gsarenas/REC-3DP/FIRMWARE/README.md

## REC_3DP_V2  
Firmware funcional com a programação necessária para o projeto

## REC_3DP_V3
Firmware funcional completo com interface visual com comunicação UART (serial USB)  
Funções básicas implementadas:
* F___: Feed Rate (controle da velocidade do motor)
* M104 S___: Set Hotend Temperature (controle da temperatura do hotend)

## Bibliotecas  
Para o funcionamento deste projeto, foram utilizadas as bibliotecas:  
* LiquidCrystal_I2C: [LiquidCrystal-master](Bibliotecas/LiquidCrystal_I2C-master.zip)  
* MightyCore: [MightyCore-master](Bibliotecas/MightyCore-master.zip)
