gsarenas/REC-3DP/FIRMWARE/REC_3DP_V3/usr/IMG/CTC-Mode-Diagram-Pequeno.png

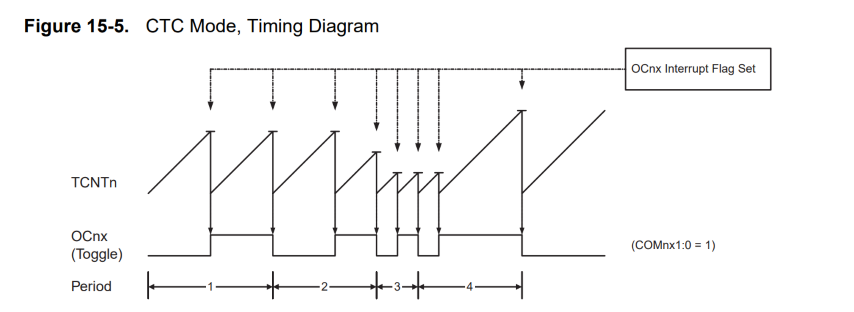
FIRMWARE/REC_3DP_V3/usr/IMG/CTC-Mode-Diagram-Pequeno.png
