gsarenas/REC-3DP/HARDWARE/ELÉTRICA/REF/Ender_3_Mainbord_PCB.png

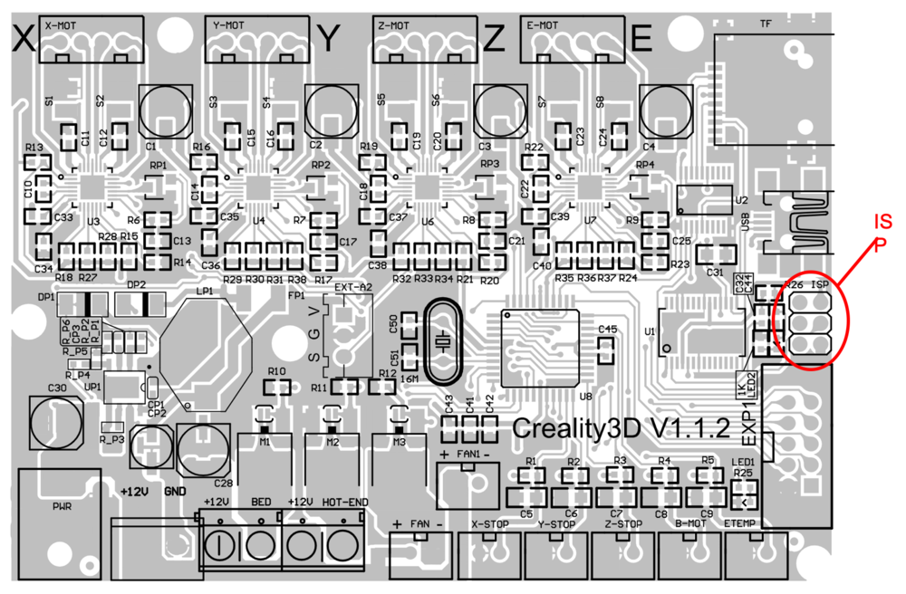
HARDWARE/ELÉTRICA/REF/Ender_3_Mainbord_PCB.png
