gsarenas/REC-3DP/HARDWARE/ELÉTRICA/REF/lcd_display_dimensions.png

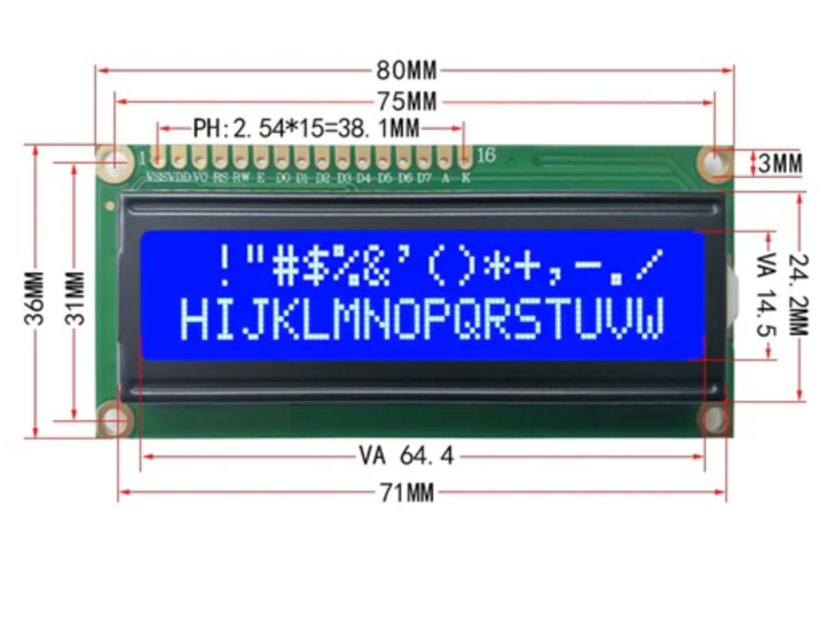
HARDWARE/ELÉTRICA/REF/lcd_display_dimensions.png
