gsarenas/REC-3DP/HARDWARE/ELÉTRICA/REF/Generic_3D_Printer_Controller_Board_PCB_Layout.jpg

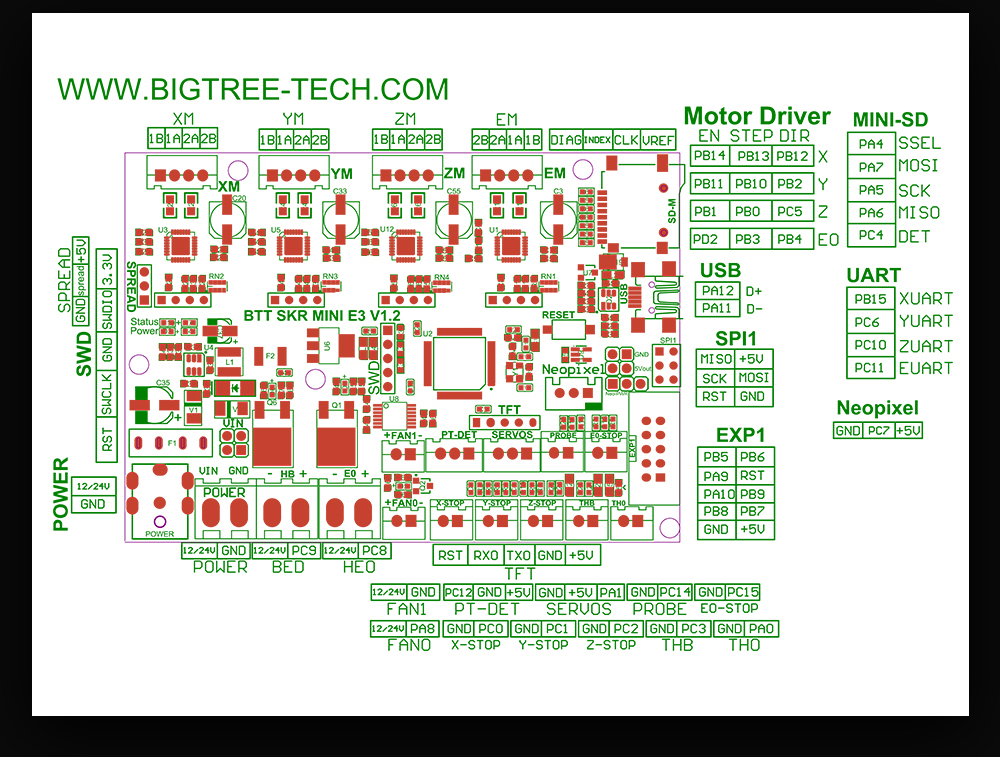
HARDWARE/ELÉTRICA/REF/Generic_3D_Printer_Controller_Board_PCB_Layout.jpg
