gsarenas/REC-3DP/FIRMWARE/REC_3DP_V3/usr/IMG/Testes_SP-150_Kp-35_Limpo.png

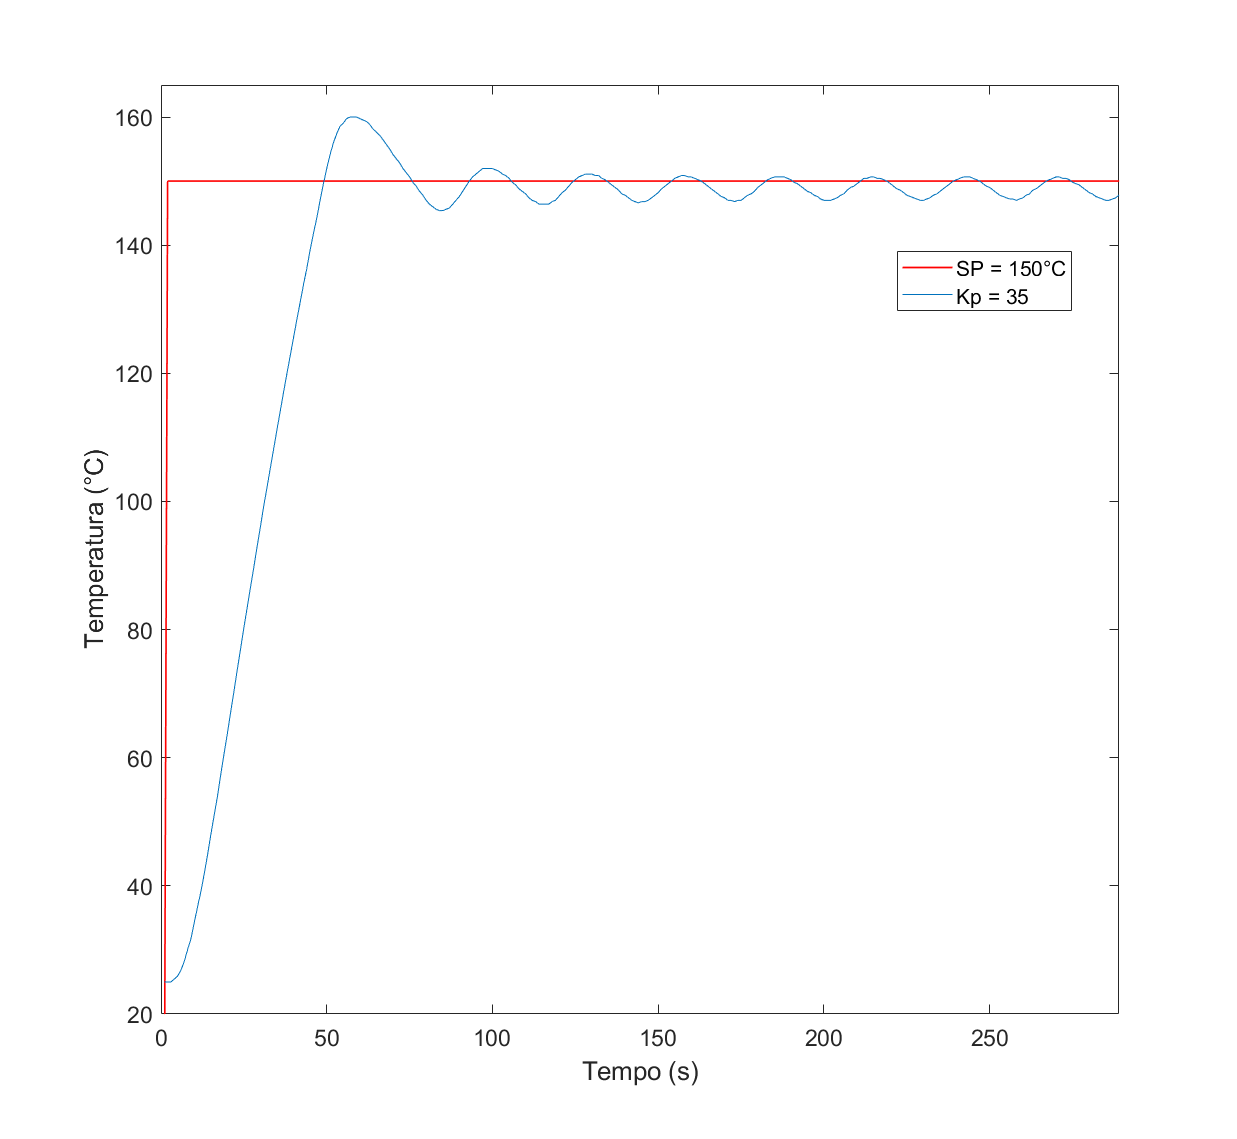
FIRMWARE/REC_3DP_V3/usr/IMG/Testes_SP-150_Kp-35_Limpo.png
