gsarenas/REC-3DP/HARDWARE/ELÉTRICA/REF/Ender_3_Schematic.PDF

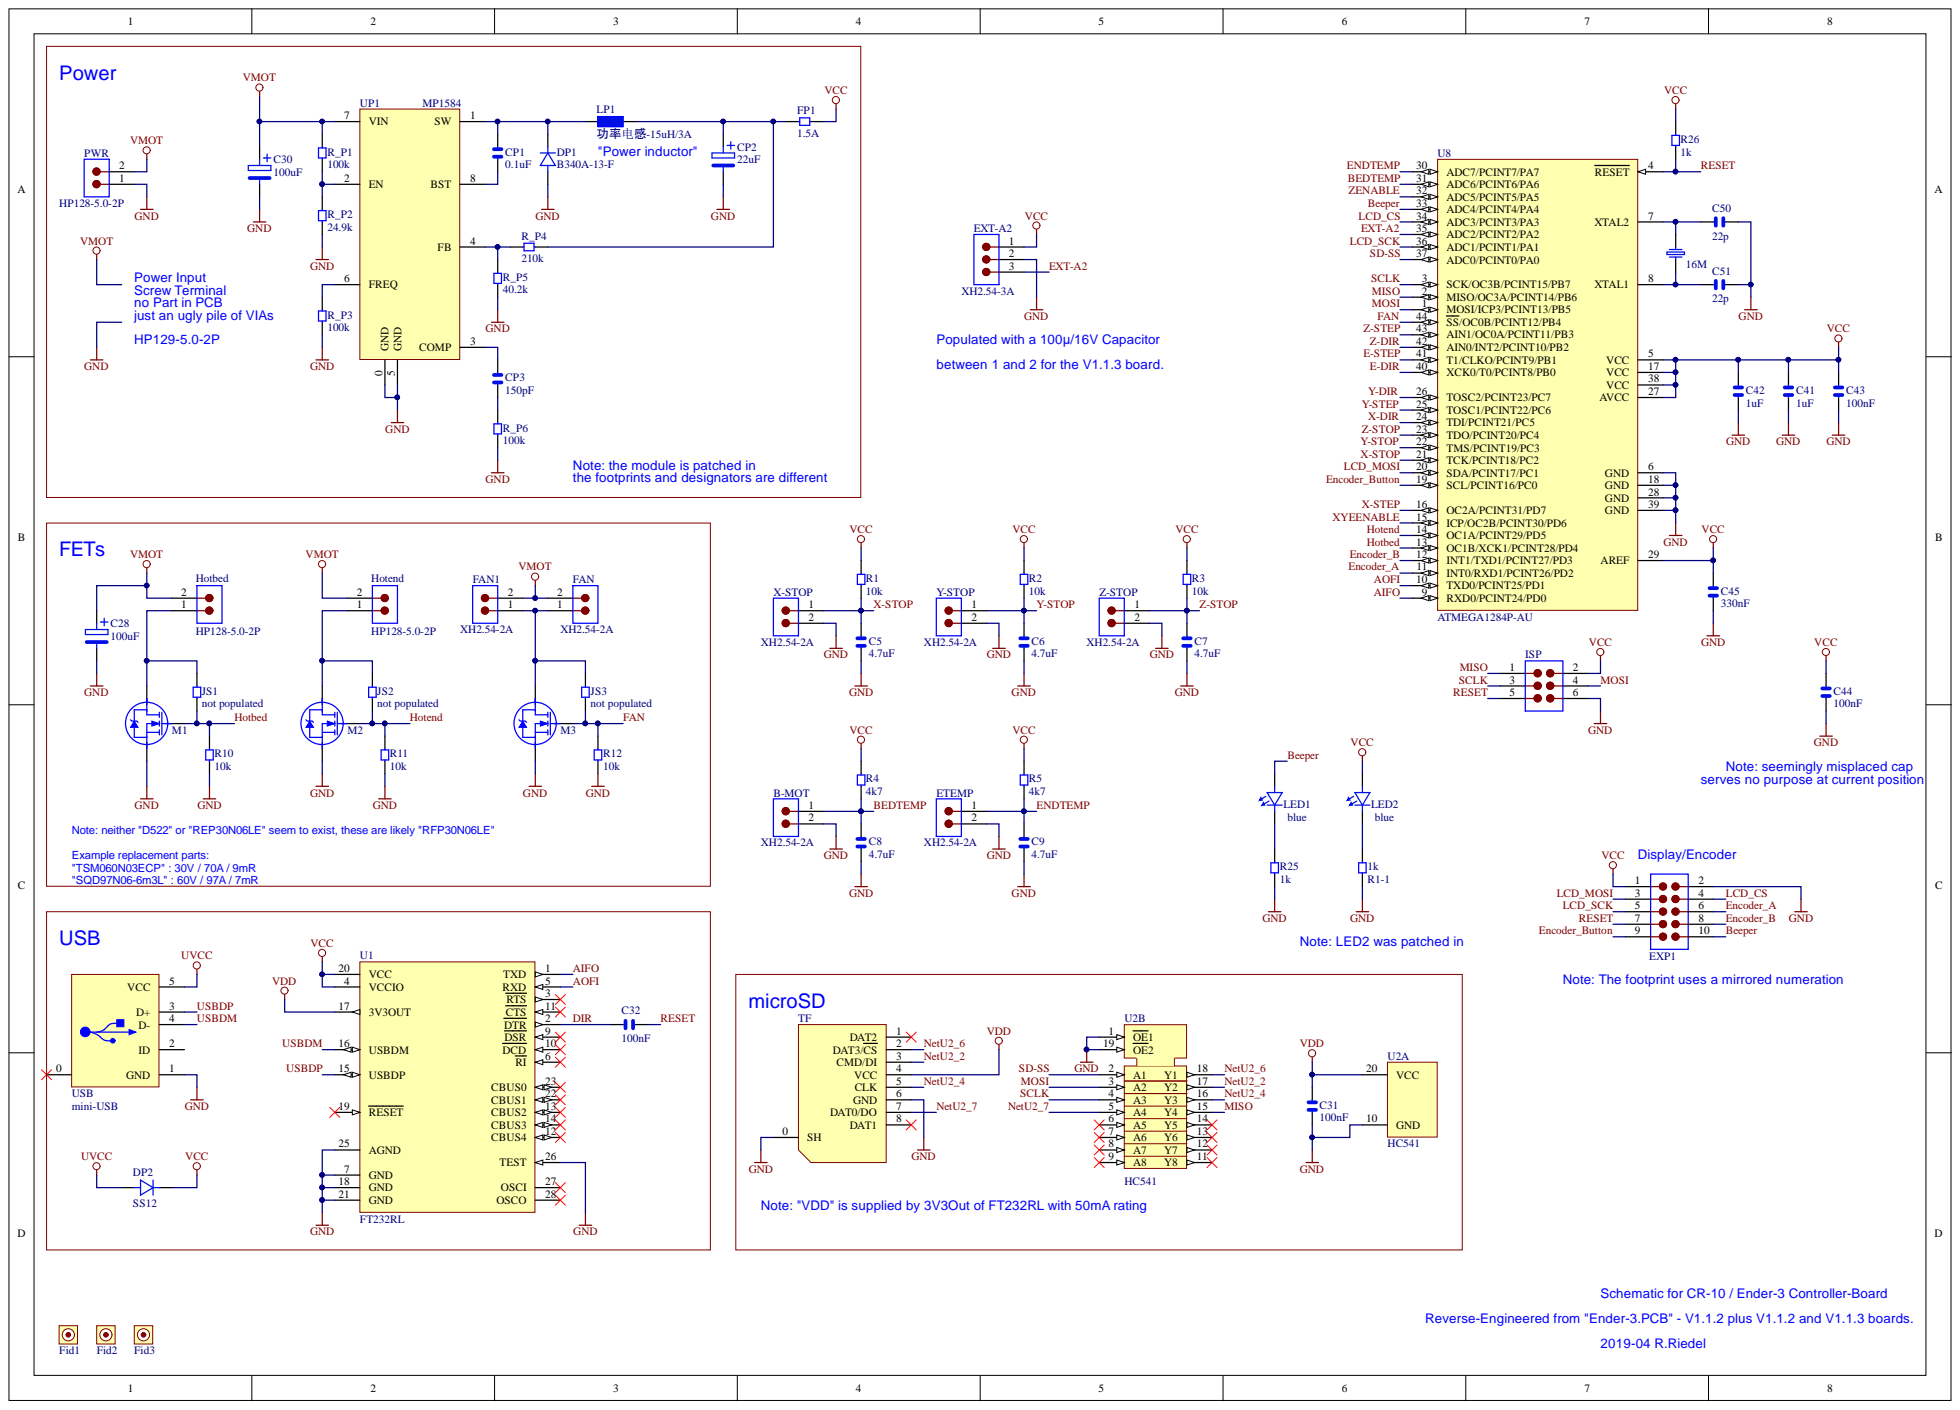
[picture p22: page 1]

Power Input
Screw Terminal no Part in PCB

just an ugly pile of VIAs

between 1 and 2 for the V1.1.3 board.

Note: the module is patched in
the footprints and designators are different

serves no purpose at current position Note: seemingly misplaced cap

Note: neither "D522" or "REP30N06LE" seem to exist, these are likely "RFP30N06LE"

GND
Note: LED2 was patched in

Note: The footprint uses a mirrored numeration

GND 7

GND 21

Note: "VDD" is supplied by 3V3Out of FT232RL with 50mA rating

Schematic for CR-10 / Ender-3 Controller-Board

Reverse-Engineered from "Ender-3.PCB" - V1.1.2 plus V1.1.2 and V1.1.3 boards.

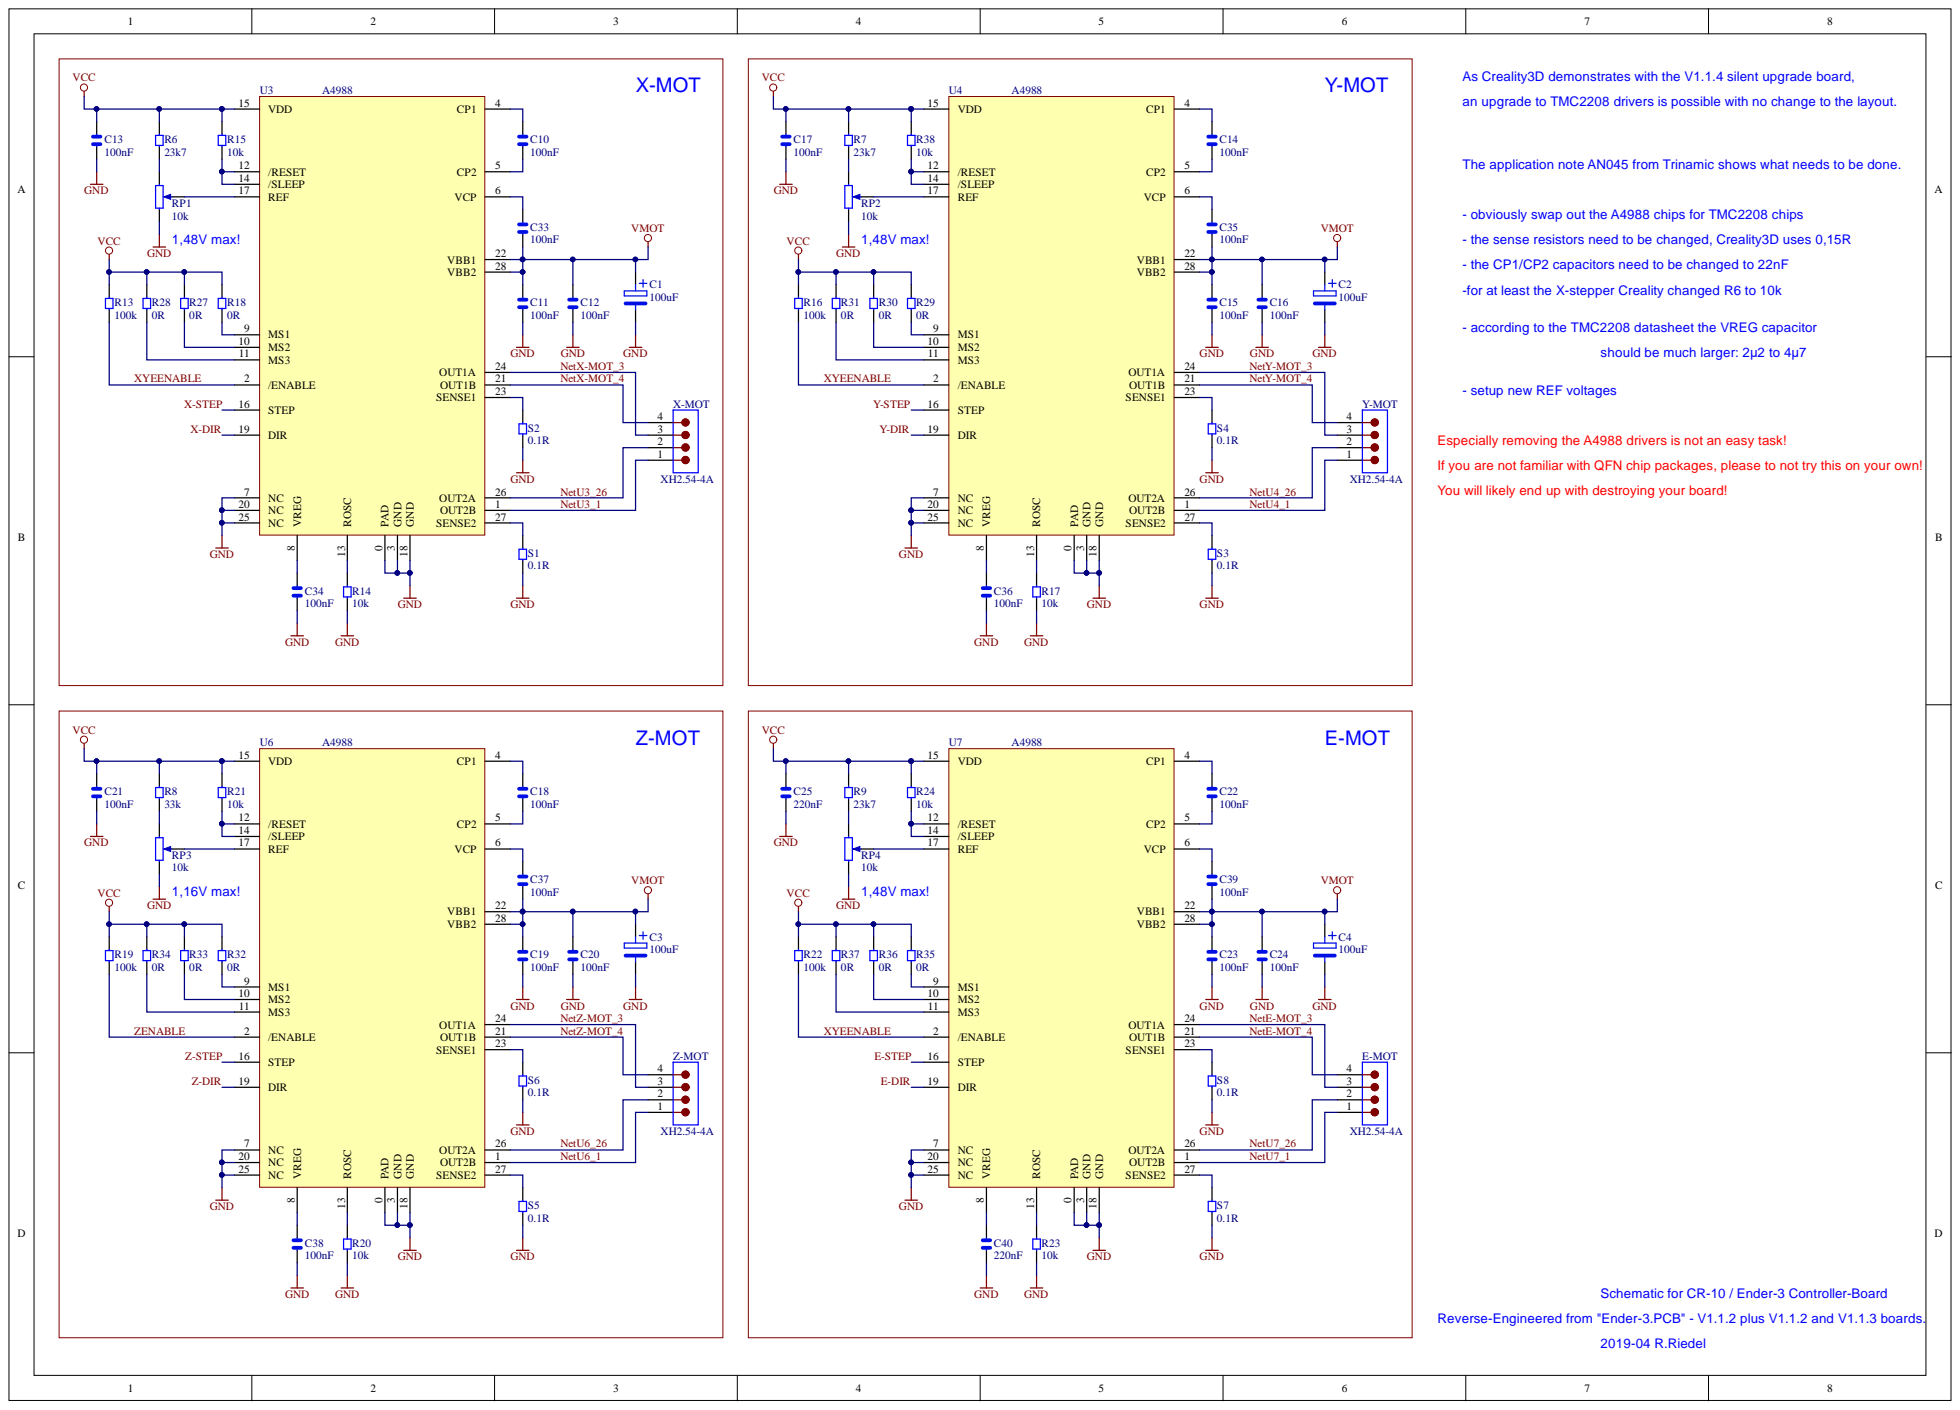
[picture p23: page 2]

As Creality3D demonstrates with the V1.1.4 silent upgrade board,

an upgrade to TMC2208 drivers is possible with no change to the layout.

The application note AN045 from Trinamic shows what needs to be done.

- obviously swap out the A4988 chips for TMC2208 chips

- the sense resistors need to be changed, Creality3D uses 0,15R

- the CP1/CP2 capacitors need to be changed to 22nF

-for at least the X-stepper Creality changed R6 to 10k

- according to the TMC2208 datasheet the VREG capacitor

should be much larger: 2µ2 to 4µ7

- setup new REF voltages

Especially removing the A4988 drivers is not an easy task!

If you are not familiar with QFN chip packages, please to not try this on your own!

You will likely end up with destroying your board!

Schematic for CR-10 / Ender-3 Controller-Board

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
