gsarenas/REC-3DP/(commit log)

2023-05-20 Mudancas de otimizacao
2023-06-06 Inclusão de notas técnicas e pequenas correções de código
2023-06-06 Inclusão novo fan 24V
